Pejo-306/digital-function-generator/hardware/signal-generator/signal-generator.kicad_pcb

## KiCad design hardware/signal-generator/signal-generator.kicad_pcb (2019-04-28)

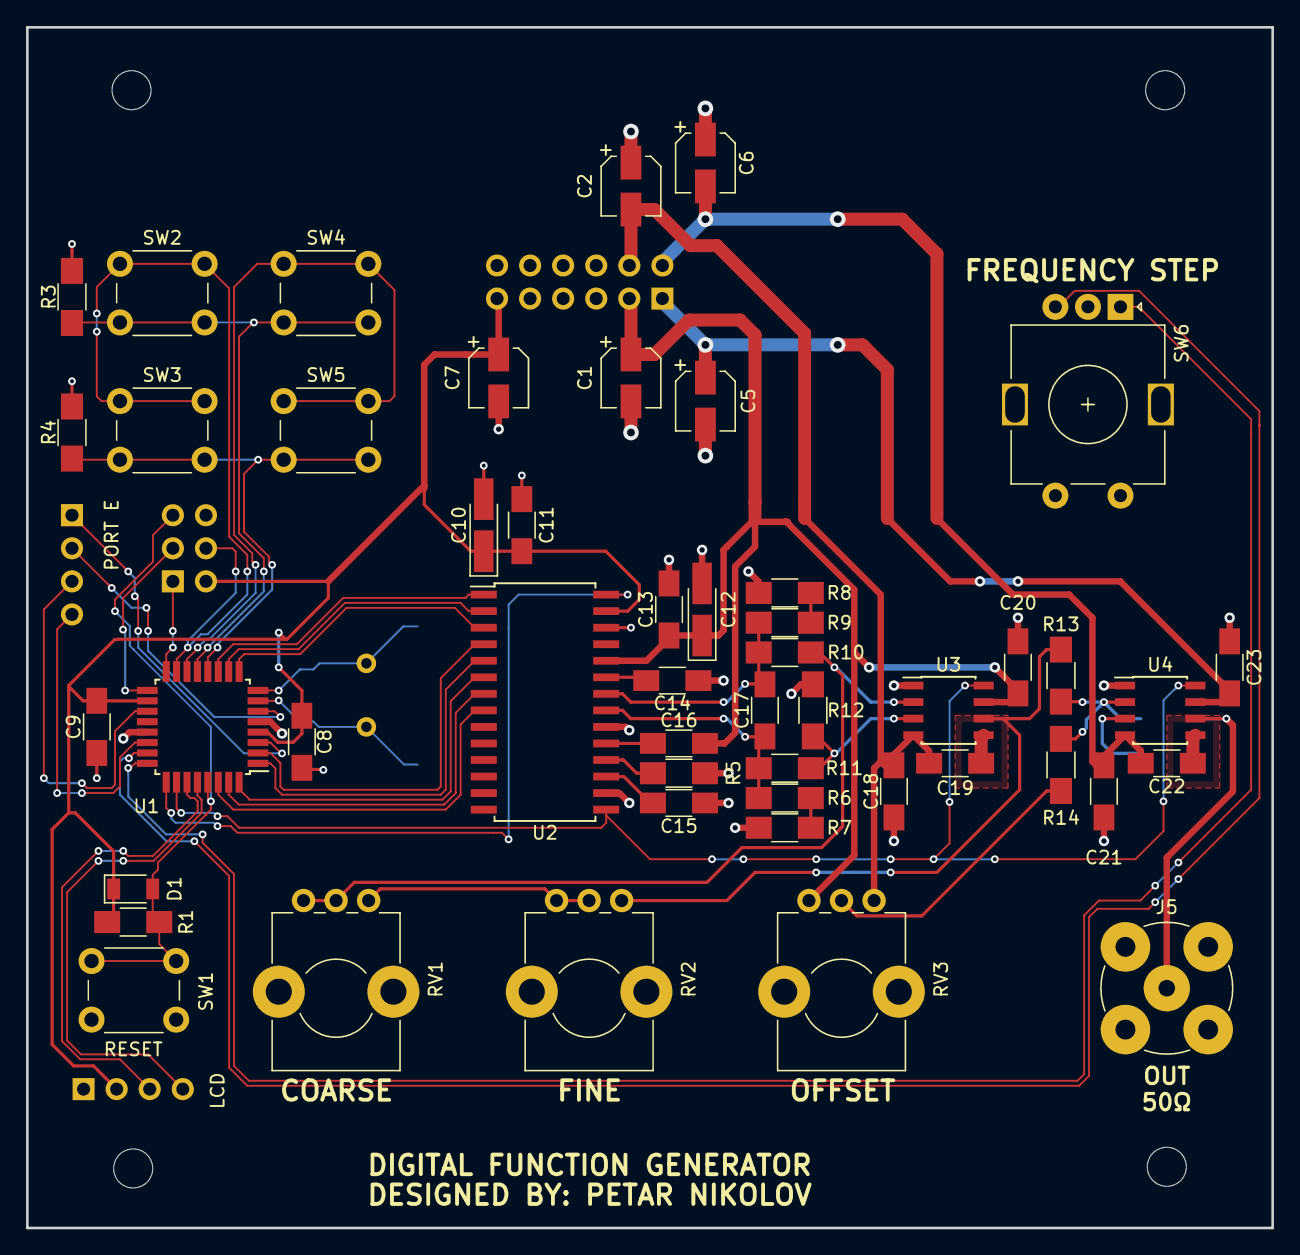
[picture p1: board signal-generator.kicad_pcb from above]

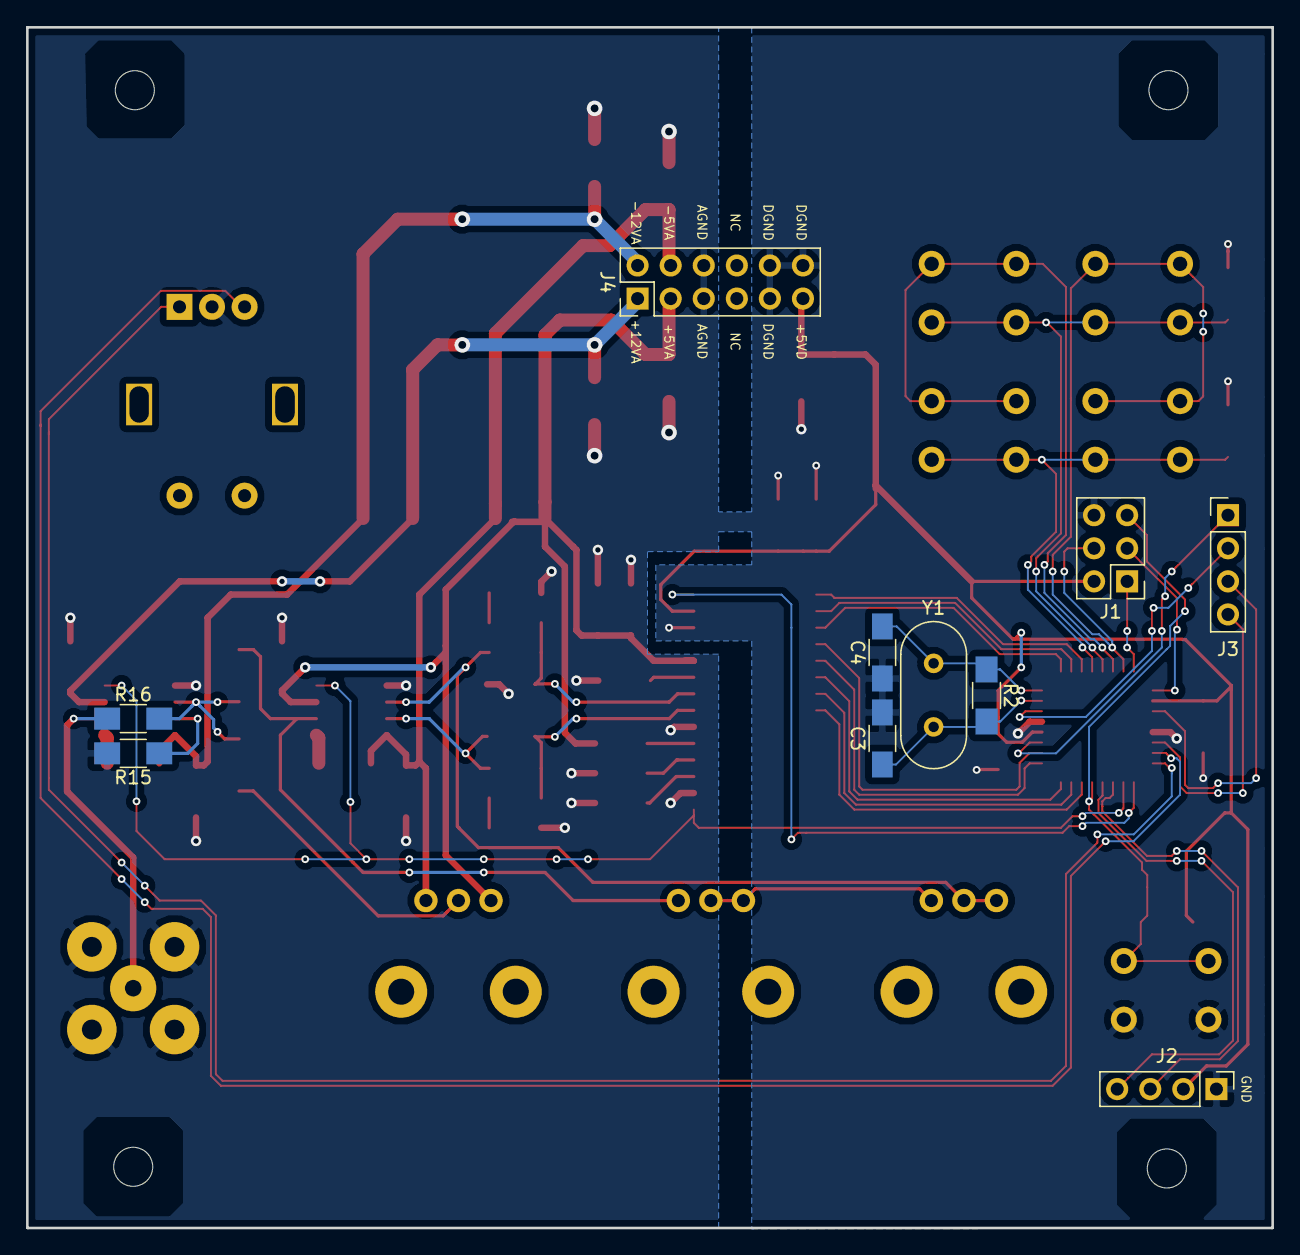
[picture p2: board signal-generator.kicad_pcb from below]

Board: 2 copper layers, 95.6 x 92.2 mm, 59 parts (10 on the bottom side), 51 nets.

Parts:
C1, C2, C5, C6, C7: 10uF/16V; CP_Elec_4x5.3
C3, C4: 22pF; C_1206_HandSoldering
C8, C9, C11, C13, C14, C15, C16, C18, C20, C21, C23: 100nF; C_1206_HandSoldering
C10, C12: 10uF/16V; CP_Tantalum_Case-A_EIA-3216-18_Hand
C17: 2.2nF; C_1206_HandSoldering
C19, C22: 6.8pF; C_1206_HandSoldering
D1: CD1206-S01575; D_1206
J1: AVR-ISP-6; Pin_Header_Straight_2x03_Pitch2.54mm
J2: LCD_Connector; Pin_Header_Straight_1x04_Pitch2.54mm
J3: PORT_E; Pin_Header_Straight_1x04_Pitch2.54mm
J4: Power_Supply_Rails; Pin_Header_Straight_2x06_Pitch2.54mm
J5: Output_Connector; bnc-ci
R1, R3, R4: 10k; R_1206_HandSoldering
R2: 1M; R_1206_HandSoldering
R5: 2k; R_1206_HandSoldering
R6, R8: 15R; R_1206_HandSoldering
R7, R9: 10R; R_1206_HandSoldering
R10, R11: 1k1; R_1206_HandSoldering
R12: 11k; R_1206_HandSoldering
R13, R14, R16: 3k; R_1206_HandSoldering
R15: 1k5; R_1206_HandSoldering
RV1, RV3: 10k; Potentiometer_Bourns_PTV09A-1_Horizontal
RV2: 1k; Potentiometer_Bourns_PTV09A-1_Horizontal
SW1: RESET_BUTTON; SW_PUSH_6mm_h4.3mm
SW2: START/STOP; SW_PUSH_6mm
SW3: MODE_SELECT; SW_PUSH_6mm
SW4: UP_ARROW; SW_PUSH_6mm
SW5: DOWN_ARROW; SW_PUSH_6mm
SW6: Frequency_Step_Rotary_Encoder; RotaryEncoder_Alps_EC11E-Switch_Vertical_H20mm
U1: ATmega328PB-AU; TQFP-32_7x7mm_Pitch0.8mm
U2: AD9708AR; SOIC-28W_7.5x17.9mm_Pitch1.27mm
U3, U4: AD8021ARZ; SOIC-8_3.9x4.9mm_Pitch1.27mm
Y1: 16MHz; Crystal_HC49-U_Vertical

Connections:
+5VA: C1.1, C12.1, C13.2, C16.1, C20.1, J4.3, RV3.1, U2.24, U3.7
+5VD: C7.1, C8.1, C9.1, C10.1, C11.1, D1.1, J1.2, J2.2, J4.11, R1.1, U1.4, U1.18, U2.27
+12VA: C5.1, C23.1, J4.1, U4.7
-5VA: C2.2, C18.2, C19.1, J4.4, RV3.3, U3.4
-12VA: C6.2, C21.2, C22.1, J4.2, U4.4
/BTN_COL0: J1.4, SW2.1, SW3.1, U1.15
/BTN_COL1: SW4.1, SW5.1, U1.14
/BTN_ROW0: R3.2, SW2.2, SW4.2, U1.13
/BTN_ROW1: R4.2, SW3.2, SW5.2, U1.12
/DAC/CLK: U1.25, U2.28
/DAC/DB0: U1.30, U2.8
/DAC/DB1: U1.31, U2.7
/DAC/DB2: U1.32, U2.6
/DAC/DB3: U1.1, U2.5
/DAC/DB4: U1.2, U2.4
/DAC/DB5: U1.9, U2.3
/DAC/DB6: U1.10, U2.2
/DAC/DB7: U1.11, U2.1
/DAC/SLEEP: U1.26, U2.15, U3.8, U4.8
/FREQ_STEP_A: SW6.A, U1.24
/FREQ_STEP_B: SW6.B, U1.23
/MISO: J1.1, U1.16
/Output_Circuitry/IINA: C17.1, R8.1, R10.2, U2.22
/Output_Circuitry/IINB: C17.2, R6.1, R11.1, U2.21
/Output_Circuitry/VOUT: J5.1, R16.1, U4.6
/SCL: J2.4, U1.28
/SCLK: J1.3, U1.17
/SDA: J2.3, U1.27
/XTAL1: C3.1, R2.2, U1.7, Y1.1
/XTAL2: C4.1, R2.1, U1.8, Y1.2
/~RESET: D1.2, J1.5, R1.2, SW1.2, U1.29
AGND: C1.2, C2.1, C3.2, C4.2, C5.2, C6.1, C7.2, C8.2, C9.2, C10.2, C11.2, C12.2, C13.1, C14.1, C15.1, C18.1, C20.2, C21.1, C23.2, J1.6, J2.1, J4.5, J4.6, J4.9, J4.10, J4.12, J5.2, R3.1, R4.1, R5.1, R7.2, R9.2, R12.2, R15.2, SW1.1, SW6.C, U1.5, U1.21, U2.16, U2.20, U2.26, U3.1, U4.1
unnamed: C14.2, U2.23
unnamed: C15.2, U2.17
unnamed: C16.2, U2.19
unnamed: C19.2, U3.5
unnamed: C22.2, U4.5
unnamed: J3.1, U1.3
unnamed: J3.2, U1.6
unnamed: J3.3, U1.19
unnamed: J3.4, U1.22
unnamed: R5.2, U2.18
unnamed: R6.2, R7.1
unnamed: R8.2, R9.1
unnamed: R10.1, RV1.1, RV1.2, U3.2
unnamed: R11.2, R12.1, U3.3
unnamed: R13.1, R14.1, R16.2, U4.2
unnamed: R13.2, RV2.3, U3.6
unnamed: R14.2, RV3.2
unnamed: R15.1, U4.3
unnamed: RV1.3, RV2.1, RV2.2
