Pejo-306/digital-function-generator/(commit log)

2018-11-17 [Power Supply] Create KiCad project for the power supply
    [power-supply.kicad_pcb, power-supply.sch]
2018-11-17 [Power Supply] Add +12V/-12V supply rails
    The presented dual power supply is linear in design and utilizes two
    low power complementary voltage regulators.
    The circuit is provided with reverse polarity protection on both
    the regulators' inputs via the MOSFETs Q1 and Q2. The diodes D2 and D3
    prevent any reverse current coming into the regulators' outputs from
    damaging the voltage regulators.
    [power-supply.sch]
2018-11-18 [Power Supply] Add +5V supply rail
    The +5V supply rail is achieved via another voltage regulator. The
    latter is connected in parallel to the +12V voltage regulator.
    [power-supply.sch]
2018-11-18 [Power Supply] Add output connector for supply rails
    [power-supply.sch]
2018-11-18 [Power Supply] Add input reverse polarity protection to 5V regulator
    [power-supply.sch]
2018-12-09 [Power Supply] Change 1N4001 diodes to M7 diodes
    An SMD solution is preferred which is why the M7 diode was chosen. The
    latter is an SMD equivalent of 1N4007.
    [power-supply.sch]
2018-12-09 [Signal Generator] Create KiCad project for the signal generator board
    [signal-generator.kicad_pcb, signal-generator.sch]
2018-12-09 [Signal Generator] Add schematic page information
    [signal-generator.sch]
2018-12-09 [Signal Generator] Add power supply connector
    In addition, some 10uF capacitors have been added to smooth the power
    supply rails.
    [signal-generator.sch]
2018-12-09 [Signal Generator] Setup ATMega328PB microcontroller
    The microcontroller is powered via the +5V supply rail. Also, an
    external oscillating crystal is included to set the microcontroller's
    clock speed to 16MHz.
    [signal-generator.sch]
2018-12-09 [Signal Generator] Add button to reset microcontroller
    [signal-generator.sch]
2018-12-10 [Signal Generator] Add AVR-ISP connector
    Also, added an LED to indicate a reset.
    [signal-generator.sch]
2018-12-17 [Signal Generator] Add DAC IC and its complementary setup components
    The DAC is positioned in a hierarchical schematic sheet.
    [DAC.sch, signal-generator.sch]
2018-12-17 [Signal Generator] Change the application's power supply
    In order to achieve high precision in high speed data conversion
    applications, the analog circuitry should not share a common power
    supply rail and a common ground as the digital circuitry of the project.
    As such, there are separate +5V rails for the digital circuitry (+5VD)
    and for the analog circuitry (+5VA), as well as different grounds
    (respectively GNDD and GNDA).
    Furthermore, there are plans to use OpAmps in the DAC's output circuitry
    which are to be powered by the +5VA/-5VA rails and the +12VA/-12VA
    rails.
    The current schematic's power connections have been altered to implement
    the explained power supply changes above.
    [DAC.sch, signal-generator.sch]
2018-12-18 [Power Supply] Change power output connector
    The new power supply schematic is to supply the following rails:
    - AGND: analog circuitry ground
    - DGND: digital circuitry ground
    - +12V/-12V dual rails (to AGND)
    - +5V/-5V dual rails (to AGND)
    - +5V digital rail (to DGND)
    [power-supply.sch]
2018-12-20 [Signal Generator] Add output circuitry hierarchical sheet
    Also, added a few TODO comments.
    [DAC.sch, output-circuitry.sch, signal-generator.sch]
2018-12-20 [Signal Generator] Add TSH80 schematic symbol
2018-12-22 [Signal Generator] Design first output amplifier stage
    Firstly, the complementary current outputs of the DAC are converted into
    small voltage signals (+- 5V). These signals are passed to an amplifier
    stage, configured in a differential output configuration, where both
    small input signals are combined into one amplified single-ended signal.
    The gain of this amplifier stage can be varied via two potentiometers -
    one for coarse adjustments, one for fine.
    The small capacitor connected between the complementary current outputs
    of the DAC introduces a low-pass filter. The latter serves to smooth out
    the output of the DAC. Its cutoff frequency is around 1.6MHz.
    [output-circuitry.sch]
2018-12-22 [Signal Generator] Design second output amplifier stage
    The second output amplifier stage is a summing OpAmp which adds together
    two signals - the amplified waveform and a DC offset. The latter ranges
    from +5V to -5V.
    [output-circuitry.sch]
2018-12-26 [Signal Generator] Minor changes
    Changes:
    - changed bypass caps symbols in DAC schematic to non-polarized 100nF
    caps (from 0.1uF polarized)
    - add protection diode between ATMega328PB's 'RESET' pin and +5VD
    - add BNC output connector
    - remove comments
    [DAC.sch, signal-generator.sch]
2018-12-26 [Signal Generator] Add 16x2 LCD with I2C module symbol
2018-12-26 [Signal Generator] Add 16x2 LCD for project's display
    [DAC.sch, output-circuitry.sch, signal-generator.sch]
2018-12-26 [Signal Generator] Add control button matrix
    The four buttons are arranged in a 2x2 matrix. Their functionalities are
    described below:
    - START/STOP - begins or ends the generation of the waveform;
    - MODE_SELECT - selects whether to change the waveform type of the
    frequency of the waveform;
    - UP_ARROW - increment the value of the frequency/select the next
    waveform;
    - DOWN_ARROW - decrement the value of the frequency/select the
    previous waveform.
    Note: The microcontroller's pins which are used for operating the button
    matrix may change at a later date.
    [signal-generator.sch]
2019-01-09 [Signal Generator] Change pin connections
    The following connections have been altered:
    - 'PC0-PC3' -> 'PB0-PB3': change button matrix's connections to
    ATMega328PB;
    - 'PB0-PB1' -> 'PC0-PC1': change LCD's connections to ATMega328PB.
    [signal-generator.sch]
2019-01-09 [Signal Generator] Add frequency step rotary encoder
    This rotary encoder is responsible for setting the frequency step used
    to change the frequency of the generated waveform.
    [signal-generator.sch]
2019-01-09 [Signal Generator] Label and reorganize. Make some connections
    All functional blocks of the main schematic have been separated into
    sections enclosed by graphical lines and labeled with headers. Only the
    LCD module is not confined by such a functional block.
    The output amplifier schematic sheet has also been labeled in a similar
    manner. The amplifier has been split into two sections: the waveform
    amplifier stage and the DC offset summing amplifier stage.
    Changes to electrical connections:
    - connect DAC's 'SLEEP' and 'CLK' pins respectively to the
    ATMega328PB's 'PC4' and 'PC5';
    - all connections on port E (PE0-PE3) have been marked as not connected.
    [output-circuitry.sch, signal-generator.sch]
2019-01-11 [Signal Generator] Add 1M resistor in parallel to crystal
    The newly added resistor ensures resonator startup.
    [signal-generator.sch]
2019-01-11 [Signal Generator] Change pin connections of LCD
    The LCD's I2C module's communication pins have been connected to the
    ATMega328PB's SDA('PC4') and SCL('PC5') pins. Furthermore, the following
    connections have been rewired to accommodate this change:
    - the rotary encoder now uses the controller's 'PC0' and 'PC1' pins;
    - the DAC's SLEEP hierarchical pin has been connected to 'PC3', the
    'CLK' - to 'PC2'.
    [signal-generator.sch]
2019-01-15 [Signal Generator] Finalize schematic
    The signal generator's PCB design may soon commence as the board's
    schematic is now fully complete. The changes in this commit include:
    - Change the potentiometers' and resistors' resistance values in the
    signal amplifying output stage's circuit because the previous values
    (3.9k and 560R) are not manufactured;
    - Replace the 5pF capacitor in the feedback circuit of the LM318-M
    OpAmp with 2x10pF capacitors in series. This was done as 10pF
    capacitors are substantially cheaper and easier to find compared to
    5pF capacitors;
    - Replace the 25 ohm resistors, which are placed immediately after both
    complementary current outputs of the DAC, with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
    [DAC.sch, output-circuitry.sch, signal-generator.sch]
2019-01-20 [Signal generator] Change amplifier's pots' values
    The signal amplifier stage's potentiometers have been changed to 10k+1k,
    whilst the DC offset stage's pot has been set to 10k. This change was
    implemented because the stated pot values are easier to find on the
    market. Furthermore, the amplifier's supporting resistors have been
    adjusted.
    [DAC.sch, output-circuitry.sch, signal-generator.sch]
2019-01-20 [Signal generator] Increase LM318-M's slew rate
    The increased slew rate, which should now reach a typical value of
    150V/us, is achieved via a different auxiliary circuit. Refer to the
    LM318-M's datasheet for more details.
    [output-circuitry.sch]
2019-01-20 [Signal generator] Change electrolytic smoothing caps to 10uF/16V
    [signal-generator.sch]
2019-01-20 [Signal generator] Connect AGND and DGND in a star point
    In a single PCB mixed-signal system, the analog and digital grounds
    should be connected to each other at only one point, which is called the
    'star' point.
    Note: the star connection has been made in KiCad with a wire which
    causes the ERC to produce an error. The latter should be ignored.
    [DAC.sch]
2019-01-20 [Signal generator] Add bypass capacitors to DAC
    Both tantalum and ceramic chip capacitors have been used to bypass both
    power supplies of the AD9708.
    [DAC.sch]
2019-01-23 [Signal generator] Include example layout of components on PCB
    The presented layout is NOT final and will definitely be altered in the
    upcoming updates. However, the final layout should roughly resemble the
    current example one.
    [signal-generator.kicad_pcb]
2019-01-23 [Signal generator] Add 4 pin connector to ATMega328PB's port E
    The additional connector is optional. The latter outsources the
    microcontroller's port E which may be used for additional functionality.
    [signal-generator.kicad_pcb, signal-generator.sch]
2019-01-23 [Signal generator] Assign 3D models to components
    Not all components have had a 3D model associated with them because I
    have chosen to use 3D models only from KiCad's official GitHub
    repository.
    [signal-generator.kicad_pcb]
2019-01-26 [Signal generator] Change power supply connector
    The power supply connector has been changed from a 8-pin one to a
    10-pin. Both additional pins connect to DGND. This allows for a better
    and more robust connector to the digital ground plane. Furthermore, it
    is necessary if external digital devices are to communicate with the
    microcontroller via the additional port E.
    [signal-generator.sch]
2019-01-26 [Signal generator] Route components no PCB
    This is not the final routing of the PCB. Further optimization is
    required. Moreover, the ground planes have not been placed.
    [signal-generator.kicad_pcb]
2019-01-27 [Signal generator] Finalize PCB layout
    The presented board design is final for rev. 1. Here is a list of
    changes introduced since the last commit:
    - The power supply's connector has been changed from a 10-pin
    one to a 12-pin. The additional 2 pins are not connected(NC). The
    reasoning behind this change is that the 2 pins increase the space
    between the analog and digital supply rails, therefore allowing both
    ground planes to be properly separated.
    - Add digital and analog ground planes, which are connected at a star
    point (Note: both planes are displayed as one(AGND) on the board.
    This is a consequence of the direct connection of both grounds on the
    schematic sheet).
    - Opt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
    [signal-generator.kicad_pcb, signal-generator.sch]
2019-02-11 [Signal Generator] Generate gerber files
    All generated gerber files are ignored by this repository.
    [signal-generator.kicad_pcb]
2019-02-12 Ignore all gerber and drill files. Ignore my private folder
    My private folder stores information which is not directly related to
    the project (e.g. a parts list which displays all parts' prices).
2019-02-13 [Signal Generator] Add schematic symbol for AD8021
2019-02-14 [Signal Generator] Redesign output circuitry amplifier
    I have chosen to redesign the output amplifier for a number of reasons:
    - Firstly, the main reason I choose to redesign the amplifier, I couldn't
    find some of the previously used parts at an affordable price point;
    - The previously used parts were old and somewhat unconventional by
    today's standards in my opinion;
    - The newer parts have additional functionalities such as the disable
    feature which reduces the supply current needed by the opamps when
    disabled;
    - The newer parts have superior characteristics and are documented
    more thoroughly.
    The previous design is still usable but I personally prefer the newer
    design.
    [DAC.sch, output-circuitry.sch, signal-generator.sch]
2019-02-15 [Signal Generator] Layout new amplifier on PCB
    The newer amplifier's components have been placed while following the
    AD8021's datasheet recommendations as well as general PCB design
    guidelines. However, this is not the final PCB layout: further
    fine-tuning may be applied.
    [signal-generator.kicad_pcb]
2019-02-15 [Signal Generator] Finalize newer PCB board layout
    The new design is final for rev.2. In comparison to rev.1 the presented
    design implements the following changes:
    - The output circuitry has been redesigned from head to toe. The new
    circuitry utilizes Analog Devices's AD8021 opamp. These amplifiers have
    some advantages compared to the previous amplifiers: a more conventional
    interface, disable functionality for power efficiency, overall better
    static and dynamic characteristics;
    - In comparison with the previously used opamps, the newer AD8021 opamps
    require less supportive components, thus reducing the cost of the
    project, as well as increasing the available board space.
    Other introduced c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
    [output-circuitry.sch, signal-generator.kicad_pcb, signal-generator.sch]
2019-04-28 [Signal Generator] Reorganize markings on F.Fab layer
    R6 and R7's value markings were swapped (i.e. R6 had '10R' next to its
    footprint, R7 had '15R' next to its footprint). The value markings have
    been swapped.
    [signal-generator.kicad_pcb]
2019-04-28 [Power Supply] Start design of temporary supply. Design analog supply
    In order to program and troubleshoot the signal generator board, a
    temporary linear power supply is to be designed. It is meant to be easy
    to construct, having common THT parts.
    Currently, the analog power supply, which provides +12V/-12V and +5V/-5V
    rails (to AGND), has been designed. It is separated in its own hierarchical
    sheet.
    [analog-power-supply.sch, power-supply.sch]
2019-04-28 [Power Supply] Design digital supply
    The digital power supply outputs a +5V rail (to DGND). It is separated
    in its own hierarchical sheet.
    Other changes:
    - Replace +15V/-15V power flags with local net labels in analog power
    supply.
    [analog-power-supply.sch, digital-power-supply.sch, power-supply.sch]
2019-04-28 [Power Supply] Finalize design of temporary power supply
    This temporary power supply outputs the following rails:
    - +12V/-12V analog rails to AGND. These rails are connected to the
    Analog_Supply_Rails connector (J1);
    - +5V/-5V analog rails to AGND. These rails are connected to the
    Analog_Supply_Rails connector (J1);
    - +5V digital rail to DGND. This rails is outsourced to the
    Digital_Supply_Rails connector (J2).
    No PCB is planned to be implemented for this linear power supply. This
    is why footprints will not be assigned to components.
    Note: this is not the final power supply module for this project. The
    current power supply is to be used for testing and troubleshooting
    purposes.
    All remnants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
    [analog-power-supply.sch, digital-power-supply.sch, power-supply.sch]
2019-05-06 [Power Supply] Change design of analog power supply.
    The temporary analog power supply has been redesigned so that the
    +5V/-5V rails are connected to the +12V/-12V rails in series, i.e. the
    former rails are no longer supplied directly via the transformer, but
    are now powered by the +12V/-12V rails.
    Furthermore, the digital supply's output connector's pinout has been
    changed. It now has 4 pins for +5VD and 4 pins for DGND (from 2/6).
    [analog-power-supply.sch, digital-power-supply.sch, power-supply.sch]
2019-05-17 [Software] Add Makefile and AVR configuration.
    Also, the project now utilizes multiple '.gitignore' files:
    - '/.gitignore': for general file ignores and non-project specific
    details;
    - '/hardware/.gitignore': ignore temporary and generated files by KiCad;
    - '/software/.gitignore': ignore compiled object files, executables,
    etc., generated when compiling C source code for AVR microcontrollers.
2019-06-02 [Software] Add demo program to generate sine wave.
    This demo code generates a 10kHz sine wave with 256 values per period.
    If the microcontroller's single instruction cycle time is lower than the
    DAC's (AD9708) input setup time or settling time, the corresponding time
    is delayed. Otherwise, the microcontroller does not need to delay
    additionally because a single instruction takes more time to execute
    than any of the DAC's required delays.
    Also, waveform processing devices are enabled by default (their SLEEPing
    functionality is not utilized).
    No LCD display is controlled.
    The generator's control block (buttons and rotary encoder) are also not
    utilized. However, the signal's amplitude and vol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
